fetlab/rhapso/examples/basic test/basic test.3mf

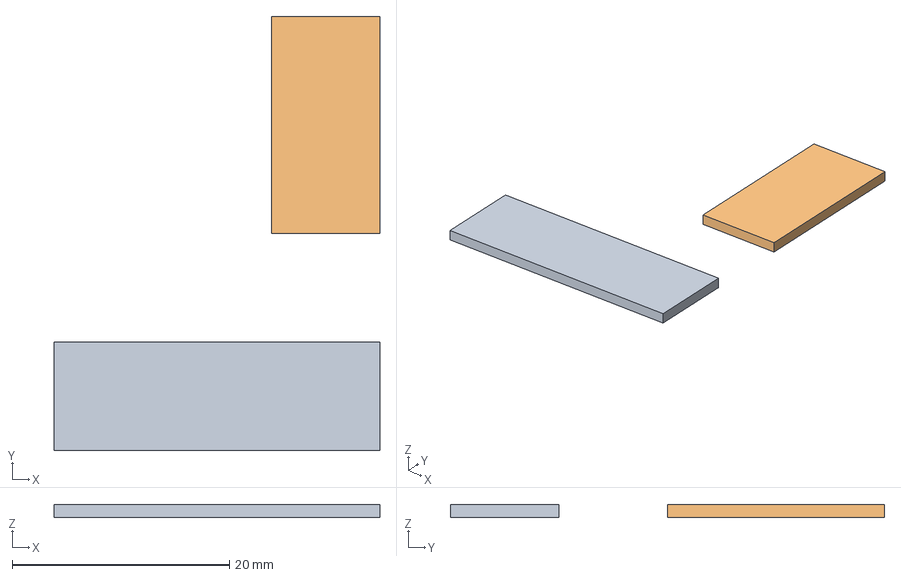
[picture p1: CAD file, 2024-10-08]
examples/basic test/basic test.3mf
30.0 x 40.0 x 1.20 mm
